marioAlonso2122/Primebot/README.md

  

  ## Descripción del proyecto

  Primebot2122 es un proyecto orientado a la creación de una plataforma sobre la que desarrollar un robot capaz de realizar el ASTI Robotics Challenge.
  Primebot2122 consiste en una placa con componentes en socket y otros soldados pensada para utilizar con Arduino y adaptable a muchas situaciones.

  ## Pruebas que realiza
  Esta plataforma se puede utilizar para un gran número de pruebas gracias a su conectividad, en mi caso prepararé las siguientes pruebas:
  - Siguelíneas
  - Cuadrícula
  - Laberinto

  Puedes encontrar la información completa del proyecto en la web: www.m2122.dev/primebot.html
