marioAlonso2122/Primebot/Docs/memoria.tex

\documentclass[a4paper,12pt,twoside]{memoir}

% Castellano
\usepackage[spanish,es-tabla]{babel}
\selectlanguage{spanish}
\usepackage[utf8]{inputenc}
\usepackage[T1]{fontenc}
\usepackage{lmodern} % Scalable font
\usepackage{microtype}
\usepackage{placeins}
\usepackage[numbers]{natbib}

\RequirePackage{booktabs}
\RequirePackage[table]{xcolor}
\RequirePackage{xtab}
\RequirePackage{multirow}

% Links
\PassOptionsToPackage{hyphens}{url}\usepackage[colorlinks]{hyperref}
\hypersetup{
	allcolors = {red}
}

% Ecuaciones
\usepackage{amsmath}

% Rutas de fichero / paquete
\newcommand{\ruta}[1]{{\sffamily #1}}

% Párrafos
\nonzeroparskip

% Huérfanas y viudas
\widowpenalty100000
\clubpenalty100000

% Imágenes
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
      \toprule
      #5
      \otoprule
    }
    \tabletail{
      \hline
      \multicolumn{#3}{r}{\small\sl continúa en la página siguiente}\\
    }
    \tablelasttail{
      \hline
    }
    \bottomcaption{#1}
    \rowcolors {2}{gray!35}{}
    \begin{xtabular}{#2}
      #6
      \bottomrule
    \end{xtabular}
    \label{tabla:#4}
  \end{center}
}

%
% Nuevo comando para tablas grandes con cabecera.
\newcommand{\tablaSinColores}[6]{%
  \begin{center}
    \tablefirsthead{
      \toprule
      #5
      \otoprule
    }
    \tablehead{
      \multicolumn{#3}{l}{\small\sl continúa desde la página anterior}\\
      \toprule
      #5
      \otoprule
    }
    \tabletail{
      \hline
      \multicolumn{#3}{r}{\small\sl continúa en la página siguiente}\\
    }
    \tablelasttail{
      \hline
    }
    \bottomcaption{#1}
    \begin{xtabular}{#2}
      #6
      \bottomrule
    \end{xtabular}
    \label{tabla:#4}
  \end{center}
}

%
% Nuevo comando para tablas grandes sin cabecera.
\newcommand{\tablaSinCabecera}[5]{%
  \begin{center}
    \tablefirsthead{
      \toprule
    }
    \tablehead{
      \multicolumn{#3}{l}{\small\sl continúa desde la página anterior}\\
      \hline
    }
    \tabletail{
      \hline
      \multicolumn{#3}{r}{\small\sl continúa en la página siguiente}\\
    }
    \tablelasttail{
      \hline
    }
    \bottomcaption{#1}
  \begin{xtabular}{#2}
    #5
   \bottomrule
  \end{xtabular}
  \label{tabla:#4}
  \end{center}
}

\definecolor{cgoLight}{HTML}{EEEEEE}
\definecolor{cgoExtralight}{HTML}{FFFFFF}

%
% Nuevo comando para tablas grandes sin cabecera.
\newcommand{\tablaSinCabeceraConBandas}[5]{%
  \begin{center}
    \tablefirsthead{
      \toprule
    }
    \tablehead{
      \multicolumn{#3}{l}{\small\sl continúa desde la página anterior}\\
      \hline
    }
    \tabletail{
      \hline
      \multicolumn{#3}{r}{\small\sl continúa en la página siguiente}\\
    }
    \tablelasttail{
      \hline
    }
    \bottomcaption{#1}
    \rowcolors[]{1}{cgoExtralight}{cgoLight}

  \begin{xtabular}{#2}
    #5
   \bottomrule
  \end{xtabular}
  \label{tabla:#4}
  \end{center}
}

\graphicspath{ {./img/} }

% Capítulos
\chapterstyle{bianchi}
\newcommand{\capitulo}[2]{
	\setcounter{chapter}{#1}
	\setcounter{section}{0}
	\setcounter{figure}{0}
	\setcounter{table}{0}
	\chapter*{\thechapter.\enskip #2}
	\addcontentsline{toc}{chapter}{\thechapter.\enskip #2}
	\markboth{#2}{#2}
}

% Apéndices
\renewcommand{\appendixname}{Apéndice}
\renewcommand*\cftappendixname{\appendixname}

\newcommand{\apendice}[1]{
	%\renewcommand{\thechapter}{A}
	\chapter{#1}
}

\renewcommand*\cftappendixname{\appendixname\ }

% Formato de portada
\makeatletter
\usepackage{xcolor}
\newcommand{\tutor}[1]{\def\@tutor{#1}}
\newcommand{\course}[1]{\def\@course{#1}}
\definecolor{cpardoBox}{HTML}{E6E6FF}
\def\maketitle{
  \null
  \thispagestyle{empty}
  % Cabecera ----------------
\noindent\vspace{1cm}%
  \vfill
  % Título proyecto y escudo informática ----------------
  
  \colorbox{cpardoBox}{%
    \begin{minipage}{.8\textwidth}
      \vspace{.5cm}\Large
      \begin{center}
      \textbf{TFG del Grado en Ingeniería Informática}\vspace{.6cm}\\
      
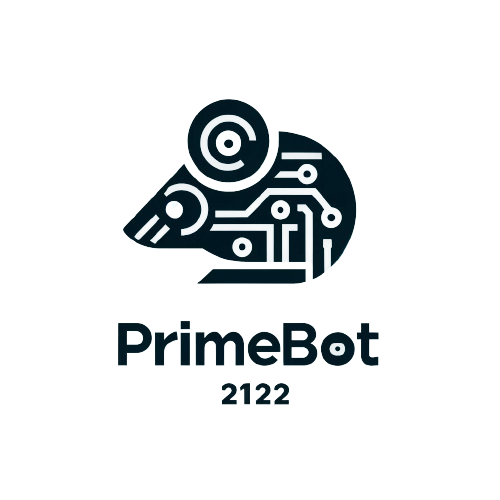
[picture p27: Docs/img/primeBotLogo.png]
	  	
	\\

      \textbf{\LARGE\@title{}}
      \end{center}
      \vspace{.2cm}
    \end{minipage}

  }%
  \hfill\begin{minipage}{.20\textwidth}
    
  \end{minipage}
  \vfill
  % Datos de alumno, curso y tutores ------------------
  \begin{center}%
  {%
    \noindent\LARGE
    Presentado por \@author{}\\ 
    en Universidad de Burgos --- \@date{}\\
    Tutor/es: \@tutor{}\\
  }%
  \end{center}%
  \null
  \cleardoublepage
  }
\makeatother

\newcommand{\nombre}{Mario Alonso Pulgar} %%% cambio de comando

% Datos de portada
\title{PrimeBot}
\author{\nombre}
\tutor{Jesús Enrique Sierra García / César Represa Pérez}
\date{\today}

\begin{document}

\maketitle

\newpage\null\thispagestyle{empty}\newpage

%%%%%%%%%%%%%%%%%%%%%%%%%%%%%%%%%%%%%%%%%%%%%%%%%%%%%%%%%%%%%%%%%%%%%%%%%%%%%%%%%%%%%%%%
\thispagestyle{empty}

\noindent\vspace{1cm}

\noindent D. Jesús Enrique Sierra García profesor del departamento de Digitalización, área de Ingeniería de Sistemas y Automática y D. César Represa Pérez profesor del departamento de Ingeniería Electromecánica y área de Tecnología Electrónica.

\noindent Expone:

\noindent Que el alumno D. \nombre, con DNI 71301872D, ha realizado el Trabajo final de Grado en Ingeniería Informática titulado PrimeBot. 

\noindent Y que dicho trabajo ha sido realizado por el alumno bajo la dirección del que suscribe, en virtud de lo cual se autoriza su presentación y defensa.

\begin{center} %\large
En Burgos, {\large \today}
\end{center}

\vfill\vfill\vfill

% Author and supervisor
\begin{minipage}{0.45\textwidth}
\begin{flushleft} %\large
Vº. Bº. del Tutor:\\[2cm]
D. Jesús Enrique Sierra García
\end{flushleft}
\end{minipage}
\hfill
\begin{minipage}{0.45\textwidth}
\begin{flushleft} %\large
Vº. Bº. del co-tutor:\\[2cm]
D. César Represa Pérez
\end{flushleft}
\end{minipage}
\hfill

\vfill

% para casos con solo un tutor comentar lo anterior
% y descomentar lo siguiente
%Vº. Bº. del Tutor:\\[2cm]
%D. nombre tutor

\newpage\null\thispagestyle{empty}\newpage

\frontmatter

% Abstract en castellano
\renewcommand*\abstractname{Resumen}
\begin{abstract}

El ASTI Robotics Challenge es una competición de robótica que 
se realiza cada año en la ciudad de Burgos y reúne a competidores 
de diferentes lugares de España.

El Proyecto PrimeBot ha sido concebido con el objetivo de desarrollar una base robótica compacta y altamente versátil. Esta base está diseñada para ser fácilmente adaptable a las diferentes pruebas del ASTI Robotics Challenge, ofreciendo una plataforma robusta y multifuncional. La complejidad y flexibilidad de PrimeBot permiten que se integre sin problemas en cualquier reto, asegurando un rendimiento óptimo en cada prueba de la competición.

PrimeBot utiliza algoritmos de control PID (Proporcional, Integral y Derivativo) para el seguimiento de líneas, lo cual es fundamental en muchas competiciones de robótica. Los parámetros del PID pueden ser ajustados en tiempo real para optimizar el comportamiento del robot en diferentes condiciones de la pista.

Una de las características destacadas de PrimeBot es su capacidad de comunicación en tiempo real a través de Bluetooth. Esto permite a los desarrolladores ajustar y monitorizar diferentes parámetros operativos del robot sin necesidad de detenerlo, facilitando así la calibración y el control durante las pruebas. La comunicación Bluetooth se integra de manera fluida con el sistema de control del robot, permitiendo ajustes dinámicos y recepción de datos en tiempo real.

El selector de programa integrado en PrimeBot permite cambiar entre diferentes modos y funciones del robot sin necesidad de conectar a un ordenador. Esta funcionalidad se implementa a través de un DIP switch, que puede detectar hasta 16 posiciones diferentes. Cada posición puede corresponder a una función específica, desde la calibración de sensores hasta la ejecución de algoritmos complejos de navegación.

\end{abstract}

\begin{center} 

\end{center}

\renewcommand*\abstractname{Descriptores}
\begin{abstract}
Robot autónomo, control bluetooth, página web.\ldots
\end{abstract}

\clearpage

% Abstract en inglés
\renewcommand*\abstractname{Abstract}
\begin{abstract}
The ASTI Robotics Challenge is a robotics competition that takes place every year in the city of Burgos and brings together competitors from different parts of Spain.
The PrimeBot Project has been conceived with the aim of developing a compact and highly versatile robotic base. This base is designed to be easily adaptable to the different tests of the ASTI Robotics Challenge, offering a robust and multifunctional platform. PrimeBot's complexity and flexibility allow it to integrate seamlessly into any challenge, ensuring optimal performance in every event of the competition.
PrimeBot uses PID (Proportional, Integral and Derivative) control algorithms for line tracking, which is critical in many robotics competitions. The PID parameters can be adjusted in real time to optimize the robot's behavior in different track conditions.
One of PrimeBot's outstanding features is its real-time communication capability via Bluetooth. This allows developers to adjust and monitor different operating parameters of the robot without having to stop it, thus facilitating calibration and control during testing. Bluetooth communication integrates seamlessly with the robot's control system, allowing dynamic adjustments and real-time data reception.
PrimeBot's integrated program selector allows switching between different robot modes and functions.

Each position can correspond to a specific function, from sensor calibration to the execution of complex navigation algorithms.

\end{abstract}

\renewcommand*\abstractname{Keywords}
\begin{abstract}
Autonomous robot, bluetooth control, web page.\ldots
\end{abstract}

\clearpage

% Indices

\tableofcontents

\clearpage

\listoffigures

\clearpage

\listoftables
\clearpage

\mainmatter
\include{./tex/1_Introduccion}
\include{./tex/2_Objetivos_del_proyecto}
\include{./tex/3_Conceptos_teoricos}
\include{./tex/4_Tecnicas_y_herramientas}
\include{./tex/5_Aspectos_relevantes_del_desarrollo_del_proyecto}
\include{./tex/6_Trabajos_relacionados}
\include{./tex/7_Conclusiones_Lineas_de_trabajo_futuras}

\bibliographystyle{plain}
\bibliography{bibliografia}

\end{document}
