marioAlonso2122/Primebot/Docs/img/n20.jpg

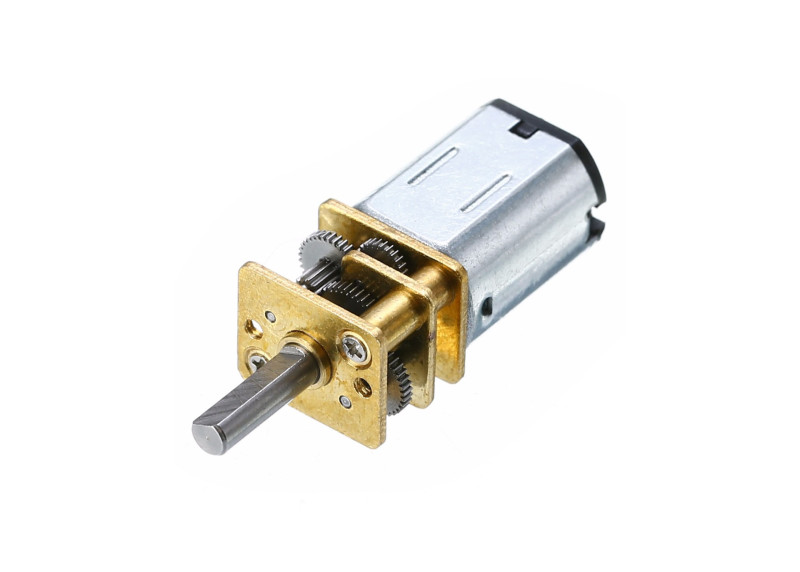
Docs/img/n20.jpg
