marioAlonso2122/Primebot/Docs/img/qtr8a.jpg

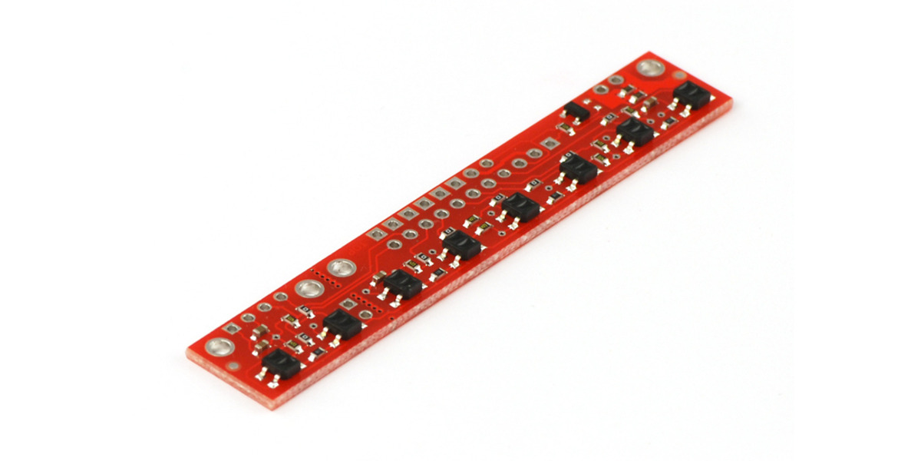
Docs/img/qtr8a.jpg
