marioAlonso2122/Primebot/Docs/img/qtr8a.png

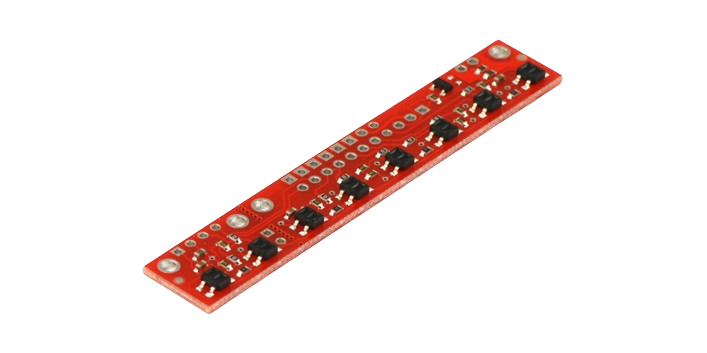
Docs/img/qtr8a.png
