marioAlonso2122/Primebot/Docs/img/tb6612fng.jpg

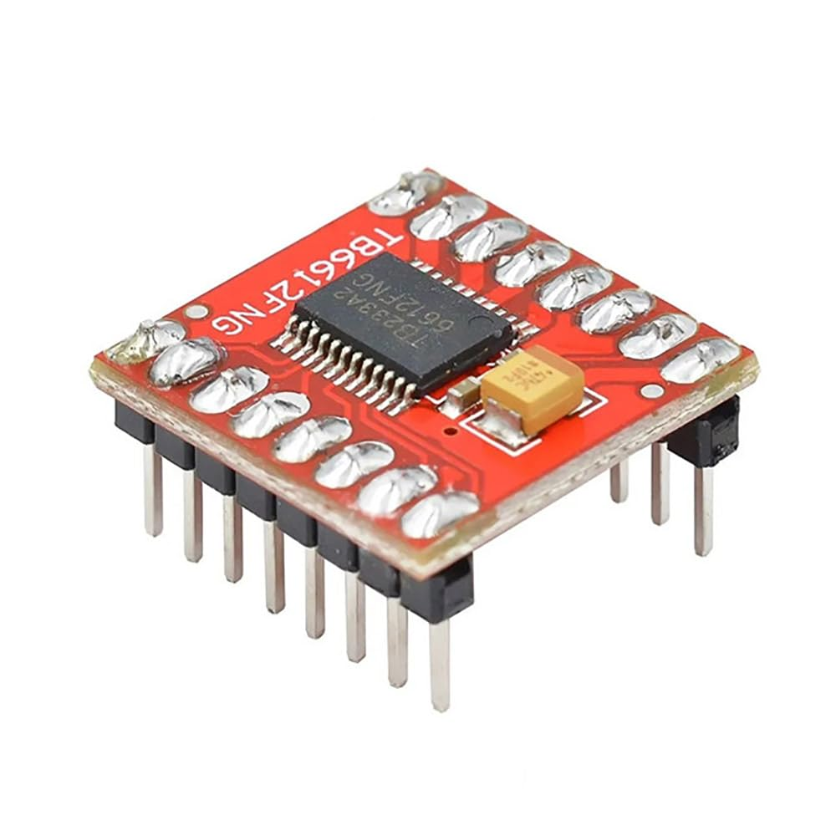
Docs/img/tb6612fng.jpg
