marioAlonso2122/Primebot/Sprint5/web/img/2122Prog.png

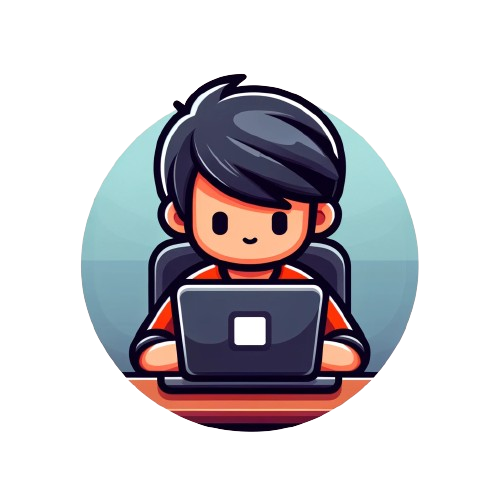
Sprint5/web/img/2122Prog.png
