marioAlonso2122/Primebot/Sprint5/web/img/dip_switch.png

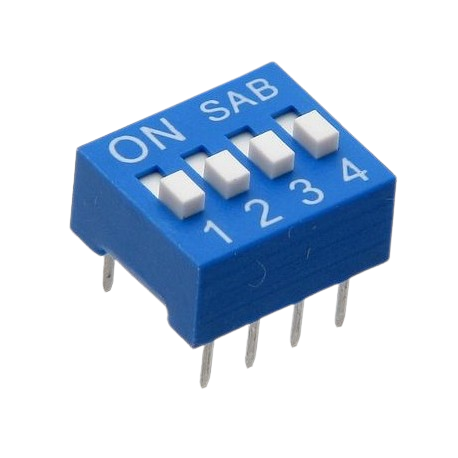
Sprint5/web/img/dip_switch.png
