marioAlonso2122/Primebot/Sprint5/web/img/n20.png

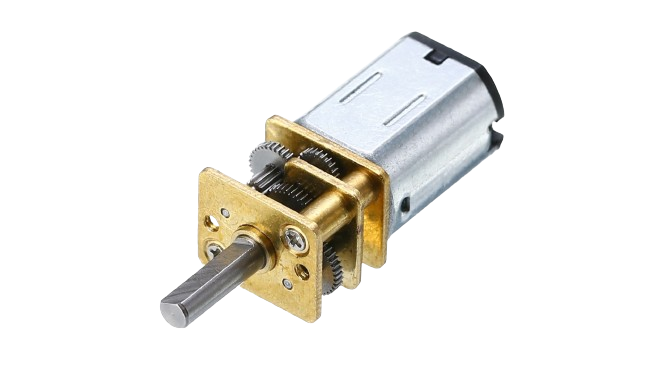
Sprint5/web/img/n20.png
