marioAlonso2122/Primebot/Sprint5/web/img/OPT3101.png

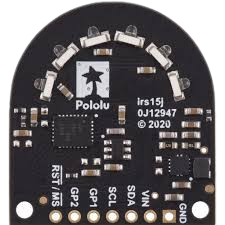
Sprint5/web/img/OPT3101.png
