marioAlonso2122/Primebot/Sprint5/web/img/qtr8A.png

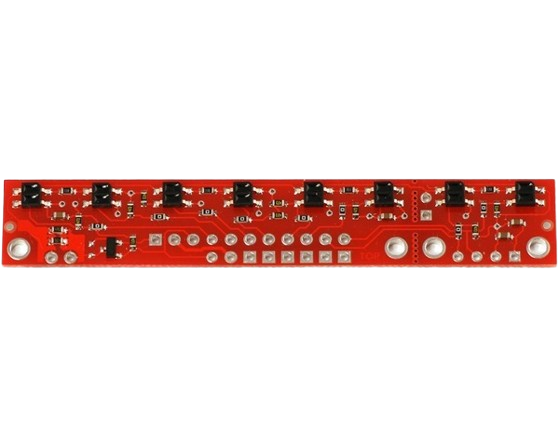
Sprint5/web/img/qtr8A.png
