marioAlonso2122/Primebot/Sprint5/web/img/small.png

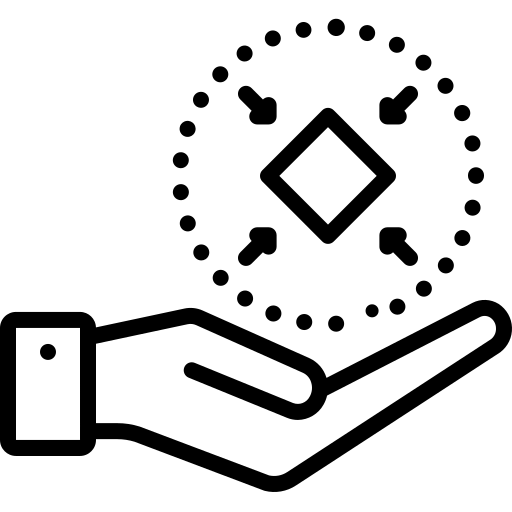
Sprint5/web/img/small.png
