marioAlonso2122/Primebot/(commit log)

2024-04-12 Upload pruebaSelector.ino
    Publicación del Script para la prueba del Selector de funciones que tiene PrimeBot
2024-04-12 Upload pruebaMotores.ino
    Subida del Script que realiza las pruebas de los motores de PrimeBot utilizando el Switch de selección
2024-04-12 Upload pruebaSelector.ino
    Subida del archivo que prueba el selector de Primebot
2024-04-18 Add files via upload
    Código de prueba de conectividad Bluetooth
2024-04-21 Prueba de Encoders Magnéticos
2024-04-21 Test de Sensores de línea
2024-04-21 Prueba de Sensores de Distancia en PrimeBot
2024-05-05 Primera Versión del PID de siguelíneas.
    PID sencillo pero funcional, ajuste mediante editor de código.
2024-05-05 Algoritmo para siguelineas final.
    Se suman las dos versiones anteriores, se añaden medidas para mejorar la estabilidad y se añade el uso de los encoders magnéticos en el funcionamiento del PID.
2024-05-14 Update siguelineasFinal.ino
    Actualización con parámetros óptimos del PID
2024-05-19 Deteccion de Cruces
    Script en el que PrimeBot se detiene unos instantes cuando detecta un cruce en la cuadricula.
2024-06-03 Deteccion de las paredes del laberinto con OPT3101
2024-06-03 Implementacion de las rutas con puntos bloqueados
2024-06-09 Archivo Main de PrimeBot
    Este archivo contiene la funcionalidad de todas las soluciones.
2024-06-09 HTML WEB
    Código html landing page PrimeBot
2024-06-09 PrimeBot JS
    Archivo JS de la web de PrimeBot.
2024-06-09 CSS PrimeBot
    CSS de la web de PrimeBot
2024-06-09 Carpeta de imagenes de web PrimeBot
2024-06-09 Imágenes web de PrimeBot
